leonardoward/Sensor-Based-Ambient-Lights/Documents/PG7232_Sistemas_Embebidos_Grupo_1_Proyecto_2.pdf

# HELA MODULE

Carlos Sanoja, Jesus Guillen, Leonardo Ward ´ | ,
Mauricio Marcano, Oscar Moreno, Vincenzo D’Argento 19-91269, 14-10460, 19-91185, 19-91204, 19-91256, 19-91256, 24287223 Universidad Simon Bol ´ ´ıvar

March 8, 2021

Abstract

El siguiente trabajo presenta las etapas del diseno de un prototipo de sistema de luces modular, que permite con ˜ el mismo hardware operar diferentes tipos de bombillos; con funcionalidades como encendido con horario, apagado
con temporizador y encendido automatico en funci ´ | on de la intensidad de la luz de fondo. Se realiza la selecci ´ | on de ´
los componentes adecuados a los requerimientos del proyecto y a los criterios del equipo de trabajo. Se realizo la ´
simulacion del funcionamiento del sistema en el software Proteus, y la codificaci ´ | on con la ayuda de MPLABX. ´

## 1 Requerimientos

### 1.1 Requerimientos Generales

Disenar un prototipo de un sistema de luces modular que permita operar diferentes tipos de bombillos. ˜

### 1.2 Requerimientos Espec´ıficos

- Ir a produccion en 4 semanas ´
- Utilizar alimentacion 110 VAC 60Hz ´
- Un costo en componentes electronicos de 7 d ´ | olares americanos sin incluir el bombillo o la fuente luminosa. ´
- Utilizar un PIC de 8bits.
- Modo de operacion encendido y apagado por sensor de intensidad luminosa. ´
- Modo de operacion encendido por alarma ´
- Modo de operacion de apagado por temporizador: 15,30,45,60 minutos ´
- El modulo debe tener un m ´ | etodo para interactuar con el usuario. ´
- El modulo debe mantener su modo de operaci ´ | on luego de una falla de energ ´ | ´ıa.
- Utilizar componentes disponibles, asequibles y con soporte en el mercado.
- El modulo se tener m ´ | etodos para programarse y verificar su funcionamiento en f ´ | abrica. ´
- El costo del ensamblaje de la l ´ | ampara se asume es de 7$ ´
- El costo de los materiales (no electr ´ | onicos) que componen la l ´ | ampara se asume es de 14$ ´
- El precio de venta del modulo al publico es de 70$
- Se desea que el costo de produccion total del modulo represente el 50% del costo de venta del producto. ´

## 2 Diseno˜

### 2.1 Hardware

En la Figura 1 se puede observar el diagrama de bloques de hardware del prototipo. Incluye los componentes esenciales
del diseno y su conexi ˜ | on: el cable de corriente, el convertidor AC/DC, el microcontrolador, la pantalla de visualizaci ´ | on, ´
los pulsadores, el sensor de intensidad luminosa, el RTC, el rele que alimenta al bombillo o en este caso a una tira ´ LED.

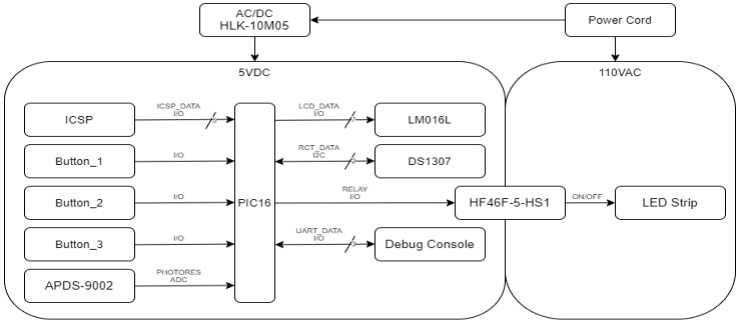
[picture p2: figure]

Figure 1: Diagrama de Bloques de Hardware

### 2.1.1 Alimentacion´

Se decidio que la fuente de luz a utilizar funcionar ´ | a con corriente alterna, de esta manera el costo del conversor AC/DC ´
pod´ıa mantener bajo ya que solo debe manejar la potencia del circuito l ´ | ogico del circuito. Se utiliz ´ | o conversor AC/DC ´
no aislado capaz de entregar 700mA a 5V con dimensiones de 3x2x2 cent´ımetros, suficiente para el consumo del PIC, la pantalla, el RTC y rele. Este se puede observar en la Figura 2. ´

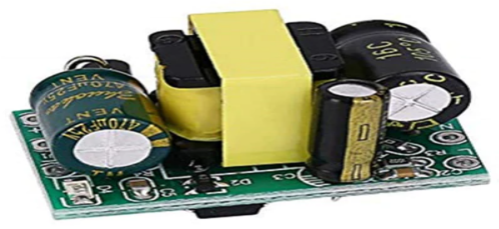
[picture p3: figure]

Figure 2: Conversor AC/DC 700mA @ 5VDC

### 2.1.2 Microcontrolador

Los requerimientos funcionales del proyecto son:

- 1 puerto de alimentacion de 5V. ´
- 6 puertos para el manejo de la pantalla LED.
- 3 puerto para los tres pulsadores que controlan el dispositivos.
- 2 puertos I2C para la comunicacion con el RTC. ´
- 1 puerto con ADC para medir el voltaje que cae en el sensor de intensidad luminosa.
- 1 puerto para manejar el rele que alimenta la fuente de luz. ´
- 2 puertos para la programacion del dispositivo v ´ | ´ıa ICSP.
- 2 puertos para el UART para comprobar el funcionamiento en fabrica.
Debido a la relativamente alta cantidad de pines que se necesitan (17 sin incluir los de alimentacion) se escogi ´ | o´
el PIC16F1768 de 20 pines, de 8 bits, que puede operar con 5V de alimentacion, una velocidad de CPU de 32MHz, ´ con 18 pines programables como I/O, protocolo I2C, 2 canales de ADC de 10 bits resolucion, 128 Bytes de memoria ´
persistente para guardar el modo de operacion que est ´ | a ejecuntado y es programable con pueto ICSP. El Pinout del ´
dispositivo puede ser observado en la Figura 3.

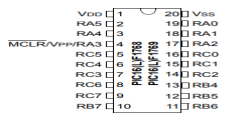
[picture p4: figure]

Figure 3: Pinout PIC16F1768

Se puede programar el microcontrolador utilizando un programador ICSP (se puede utilizar para cualquier chip PIC). Las conexiones ICSP se muestran en el siguiente diagrama (Figura 4):

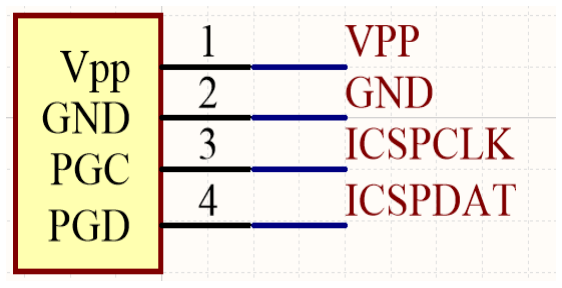
[picture p5: figure]

Figure 4: S´ımbolo para la entrada ICSP en el esquematico ´

### 2.1.3 Rele´

El dispositivo escogido para suministrar la corriente a la fuente luminosa es el popular rele HF46F-5-HS1 de la ´ marca Hongf, capaz de manejar voltajes entre sus terminales de 110-220 VAC y permitir una corriente maxima de ´
5 Amperios. Si bien el voltaje de activacion del rel ´ | e es de 5VDC, se utiliz ´ | o un transistor BC547 en conjunto con una ´
resistencia para evitar que el microcontrolador suministre los 40mA de corriente necesarios para su operacion (seg ´ | un´
su hoja de datos); ademas de un diodo 1n4007 para el retorno de la corriente cuando se abre el circuito. En la Figura ´
5 se puede observar la conexion utilizada para la simulaci ´ | on´

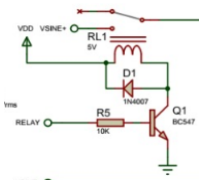
[picture p6: figure]

Figure 5: Conexion Rele HF46F-5-HS1 ´

### 2.1.4 Fuente de luz

Si bien el modulo puede operar con cualquier fuente de luz que opere en 110 o 220 VAC y no consuma mas de 5 ´
amperios. Para este diseno se escogi ˜ | o una tira LED AC (110VAC) que viene en presentaci ´ | on de 25 metros, tiene un ´
consumo de 7 Watts por metro, ademas viene en diferentes colores y puede ser cortada y empatada cada un metro. De ´
esta manera el cliente puede elegir los colores y el tamano de la tira que desee, hasta un valor te ˜ | orico de 92 metros ´
continuos (Hay que comprobar en la practica las perdidas dentro de la misma). La longitud de la tira introduce un costo ´ variable en el modulo que depende de las necesidades del cliente por eso no se incluye en el costo de los componentes electronicos. La tira se puede observar en la figura 6 ´

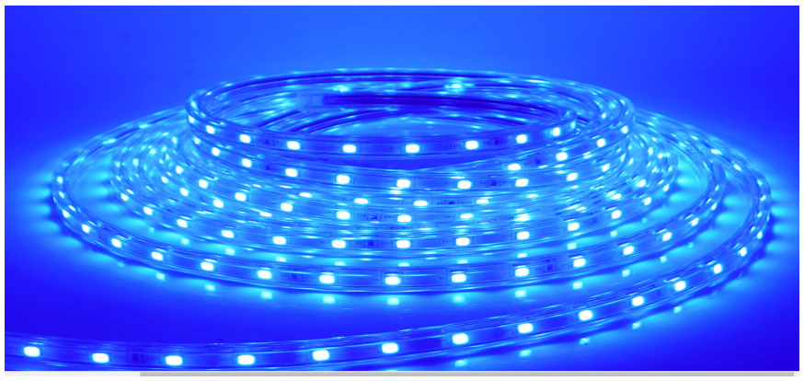
[picture p7: figure]

Figure 6: Tira LED AC Azul

### 2.1.5 Sensor de intensidad luminosa

Como sensor de intensidad luminosa se escogio el APDS-9002 de la empresa Avago Technologies. Este aparte de un ´
diminuto tamano de 2mm, puede operar con alimentaci ˜ | on de 5V. Se necesita un ADC de alta resoluci ´ | on para medir el ´
voltaje que cae en la resistencia de carga, ya que esta puede llegar a estar en el orden de los 20uA. En la figura 7 se puede observar el diagrama de conexion. ´

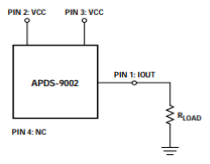
[picture p8: figure]

Figure 7: Sensor de intensidad luminosa

### 2.1.6 RTC

Se escogio un modulo RTC comercial, basado en el DS1307 de Maxim Integrated, este puede operar con alimentaci ´ | on´
de 5V, posee una porta bater´ıa y un circuito cargador para la misma. De esta manera el modulo puede mantener la hora a pesar de una falla con el suministro de la energ´ıa AC y continuar con el tiempo de ejecucion correcto cuando ´ se restablezca. En la figura 8 se puede observar fotos reales de modulo RTC.

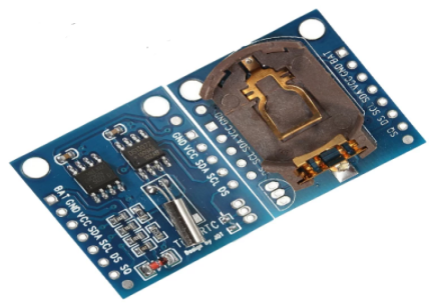
[picture p9: figure]

Figure 8: Modulo RTC basado en el DS1307 con porta bater ´ | ´ıa

### 2.1.7 Interfaz del usuario

Se escogio una pantalla LCD de 16x2 como interfaz con el usuario debido a su practicidad y bajo costo. En conjunto ´ con tres botones tipo pulsadores en configuracion pull-up que le permiten al usuario interactuar con el modulo para ´
seleccionar sus modos de operacion. En la figura 9 se puede observar estos componentes en la simulaci ´ | on´

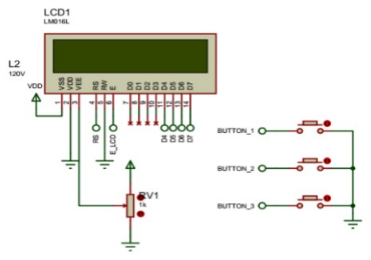
[picture p10: figure]

Figure 9: Pantalla LCD y botones

### 2.2 Software

En la Figura 10 se puede observar el diagrama de bloques del software para el microcontrolador, se pueden distinguir 6 subsistemas: i) el que controla la pantalla LDC, ii) el que configura y obtiene la hora del RTC, iii) el que obtiene la
informacion del sensor de intensidad luminosa, iv) la l ´ | ogica de los botones, v) el sistema que guarda y obtiene datos ´
de la memoria persistente y vi) la logica de encendido y apagado de las luces que integra la informaci ´ | on de los dem ´ | as´
subsistemas para determinar en que estado deben estar.

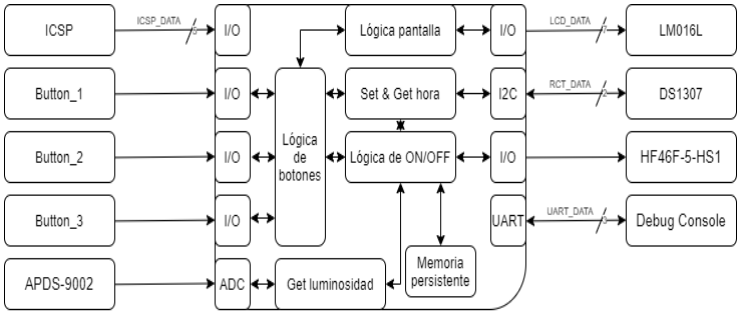
[picture p11: figure]

Figure 10: Diagrama de Bloques de Software

### 2.2.1 Implementacion´

A nivel de codigo, luego de inicializar el sistema y las variables necesarias, el programa fluye de la siguiente manera: ´

1. Se obtiene la hora del RTC.
2. Se inicializa la pantalla LED.
3. Se muestra la hora en la pantalla.
4. Se realiza la lectura de los pulsadores.
5. De haberse presionado el boton de ”select” se refresca la pantalla, ´
6. Se espera que el usuario presione otro de los botones para decidir que pantalla es la siguiente (Figura 11):
- Pantalla 1: Muestra la hora actual de dispositivo, es la primera pantalla que se muestra cuando se enciende el modulo.
- Pantalla 2: Para programar la hora del dispositivo
- Pantalla 3: Para seleccionar el modo de encendido y apagado automatico por hora. ´
- Pantalla 4: Para seleccionar el modo de encendido automatico por intensidad luminosa del ambiente. ´

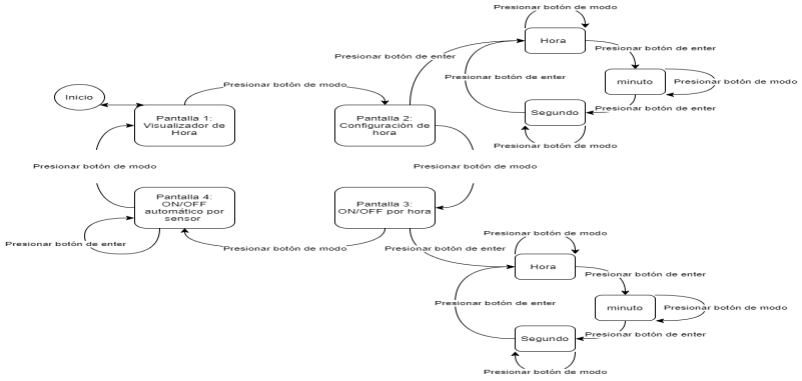
[picture p12: figure]

Figure 11: Flujo de Estados

## 3 Resultados

Se realizo la simulaci ´ | on del circuito propuesto en Proteus, en la Figura 13 se puede apreciar el dise ´ | no realizado. ˜

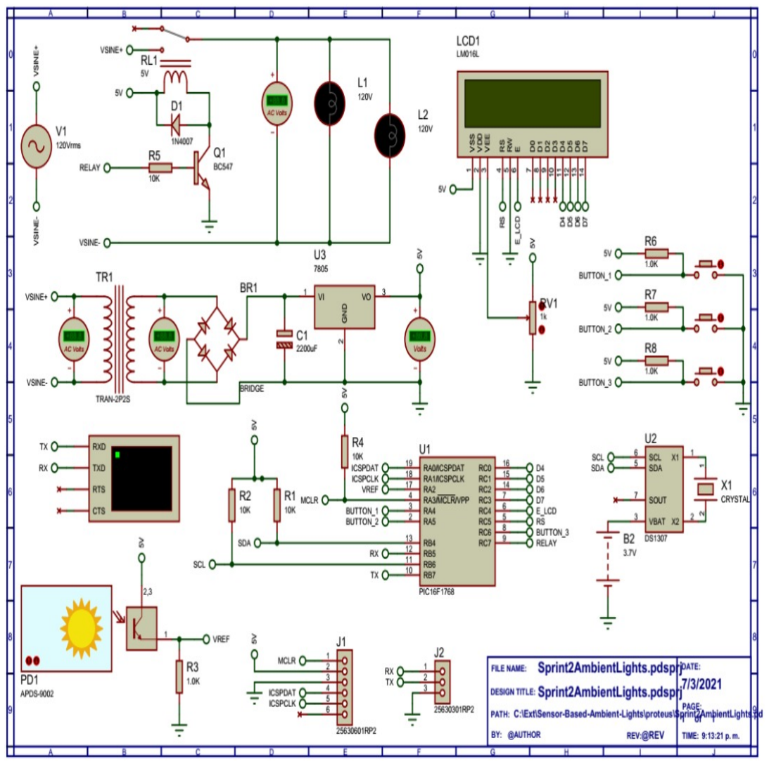
[picture p13: figure]

Figure 12: Modelo del circuito en Proteus

Al finalizar, los resultados finales de costo de fabricacion pueden ser observados en el BOM (Bill of Materials), as ´ | ´ı
como tambien las especificaciones de cada componente. En la siguiente tabla se muestran las principales conclusiones: ´
Costo | 1 unidad | 100 unidades | 1000 unidades
Costo Componentes Electronicos (sin tira LED) | $7.17 | $6.83 | $6.70 ´
Costo Componentes Electronicos (con 2 metros tira LED) | $10.65 | $10.31 | $10.18 ´
Costo de produccion | $31.65 | $31.31 | $31.18 ´
Table 1: Analisis de costo de producci ´ | on´

Si se le suman los costo de ensamblaje (7$) y el costo de los materiales de lampara en (14$), el costo de produccion´ de Hela Module con dos metros de tira LED se eleva a aproximadamente a los 31.2$ lo que representa el 44.5% del valor del precio de venta deseado de 70$. Si el cliente desea mayor longitud en la tira el costo es de 1.74$ por cada metro adicional por lo que el precio final varia en funcion de la longitud de la tira. ´
Se puede concluir que el costo de produccion de Hela Module se encuentra dentro del margen establecido en los ´ requerimientos.

## References

[1] Powell, B. Design Patterns for Embedded Systems in C: An Embedded Software Engineering Toolkit. 2010
[2] Pressman, R. Software Engineering: A Practitioner’s Approach. 2014
[3] White, E. Making Embedded Systems: Design Patterns for Great Software. 2011
