leonardoward/Sensor-Based-Ambient-Lights/images/demonstration.jpeg

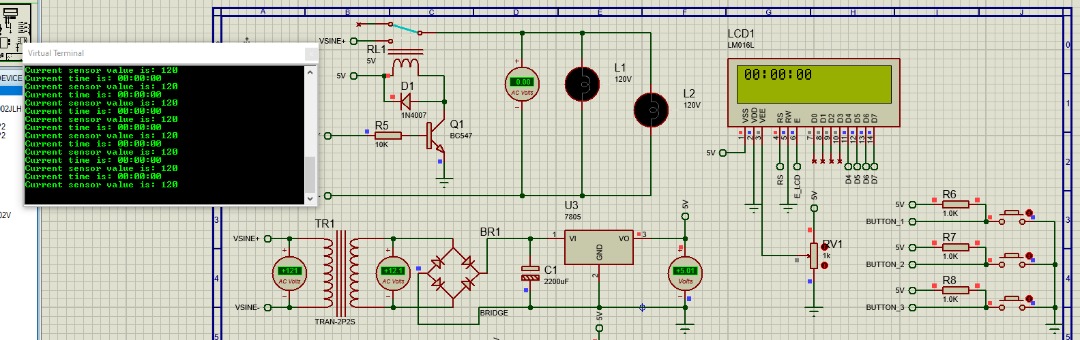
images/demonstration.jpeg
