leonardoward/Sensor-Based-Ambient-Lights/Schematic.pdf

## LCD1

L1

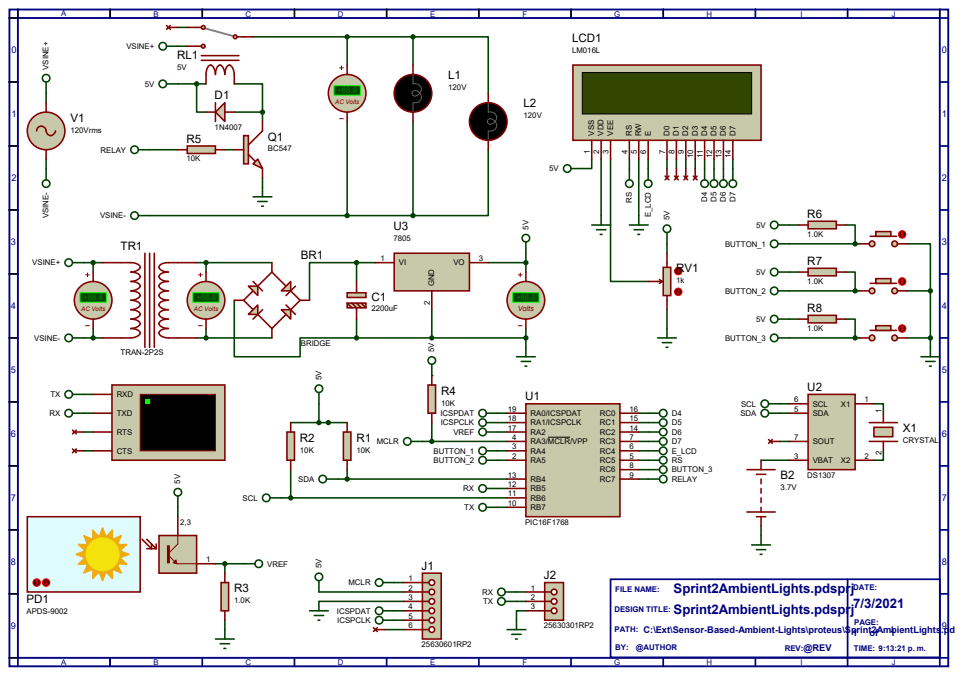
[picture p15: page 1]

Sprint2AmbientLights.pdsprj
DESIGN TITLE: Sprint2AmbientLights.pdsprj
PATH: C:\Ext\Sensor-Based-Ambient-Lights\proteus\Sprint2AmbientLights.pdsprj 1 of 1
