leonardoward/Sensor-Based-Ambient-Lights/(list of files, drawings)

Other design files:
proteus/Sprint2AmbientLights.pdsprj
