leonardoward/Sensor-Based-Ambient-Lights/(commit log)

2021-03-05 Init proteus project, added PIC16, LCD16x2 and DS1307
    [Sprint2AmbientLights.pdsprj]
2021-03-05 Added schematic
2021-03-05 FEAT: this commit will test which folders should we get in the repo
    If succeed: In another computer the compilation process should work without problem
    [main.c]
2021-03-06 FEAT: read photoresistence logic
    It was added the ADC peripherics
2021-03-06 Added photo sensor and connectors for ICSP and TX/RX
    [Sprint2AmbientLights.pdsprj]
2021-03-06 REFACTOR: changes in ADC configuration
    [New Project.pdsprj]
2021-03-06 Excluded J1 and J2 from simulation
    [Sprint2AmbientLights.pdsprj]
2021-03-06 FEAT: UART added
2021-03-06 Files moved to proteus folder
    [Sprint2AmbientLights.pdsprj]
2021-03-06 Removed simulation files
    [Sprint2AmbientLights.pdsprj]
2021-03-07 FEAT: adding changes to proteus y mplab to test ADC reading
2021-03-07 FEAT: adding voltimeter to the simulation sensor reading
2021-03-07 FEAT: removing UART internal peripheric, everyting will be config EUSART
2021-03-07 FEAT: adding function to print ADC value or integer to serial monitor
2021-03-07 REFACTOR: improvements in print function
2021-03-07 FEAT: ADC documentation in code
2021-03-07 REFACTOR: documentation ADC
2021-03-07 REFACTOR: getting newest version of proteus project
    [Sprint2AmbientLights.pdsprj]
2021-03-07 FEAT: adding relay and buttons to the project
    [Sprint2AmbientLights.pdsprj]
2021-03-07 REFACTOR: deleting uncessary folders
    [New Project.pdsprj]
2021-03-07 FEAT: updating initialization and print test in LCD screen
2021-03-07 Added AC Leds and push buttons to the simulation, new LCD pins
    [Sprint2AmbientLights.pdsprj]
2021-03-07 Removed RW net, conected RW from LCD to GND
    [Sprint2AmbientLights.pdsprj]
2021-03-07 Added 120Vac-5Vdc power source
    [Sprint2AmbientLights.pdsprj]
2021-03-08 Added 1k pull up resistors for each button
    [Sprint2AmbientLights.pdsprj]
2021-03-08 Added pull up resistors in schematic pdf
2021-03-08 FEAT: updated Proteus simulation
    [Sprint2AmbientLights.pdsprj]
